eSpark-Backup/bradford-fermin-led-control/Design Files/Main-Board-v1.0/Deliverables/Rendering/3D Bottom View.png

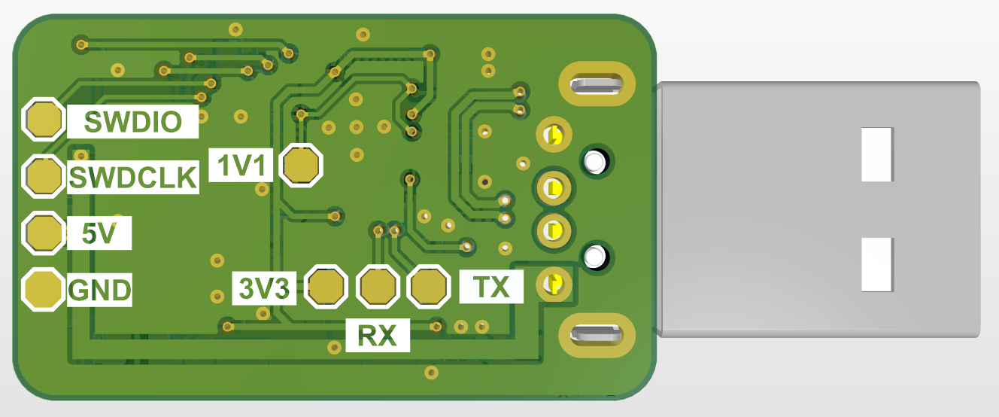
Design Files/Main-Board-v1.0/Deliverables/Rendering/3D Bottom View.png
