eSpark-Backup/bradford-fermin-led-control/Design Files/LED Board - v1.0/Deliverables/Renderings/2D View.png

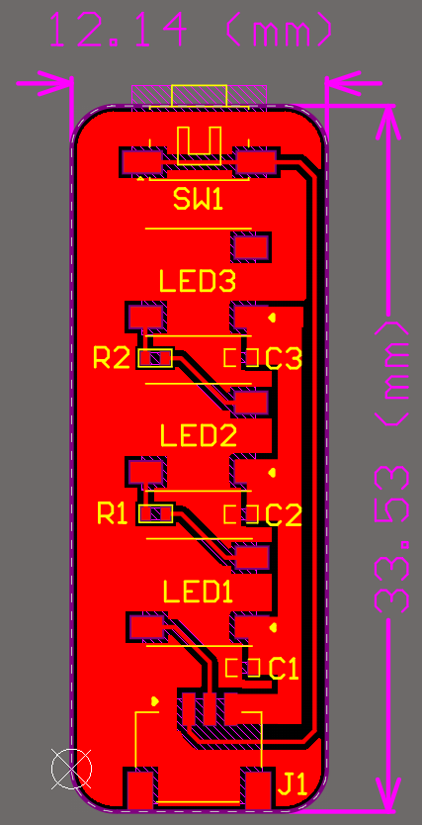
Design Files/LED Board - v1.0/Deliverables/Renderings/2D View.png
