eSpark-Backup/bradford-fermin-led-control/Design Files/LED Board - v1.0/Deliverables/Renderings/3D Bottom.png

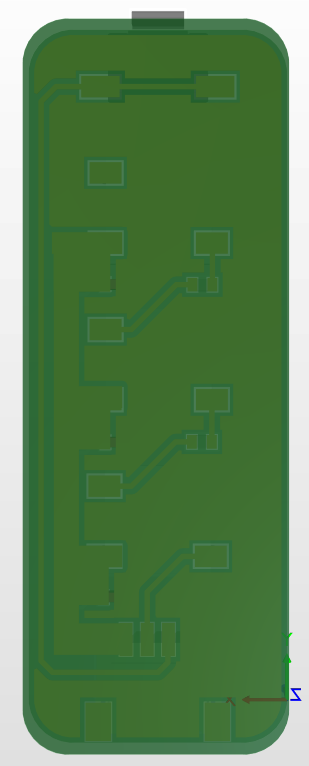
Design Files/LED Board - v1.0/Deliverables/Renderings/3D Bottom.png
