eSpark-Backup/bradford-fermin-led-control/Design Files/Main-Board-v1.0/Deliverables/Rendering/2D View.png

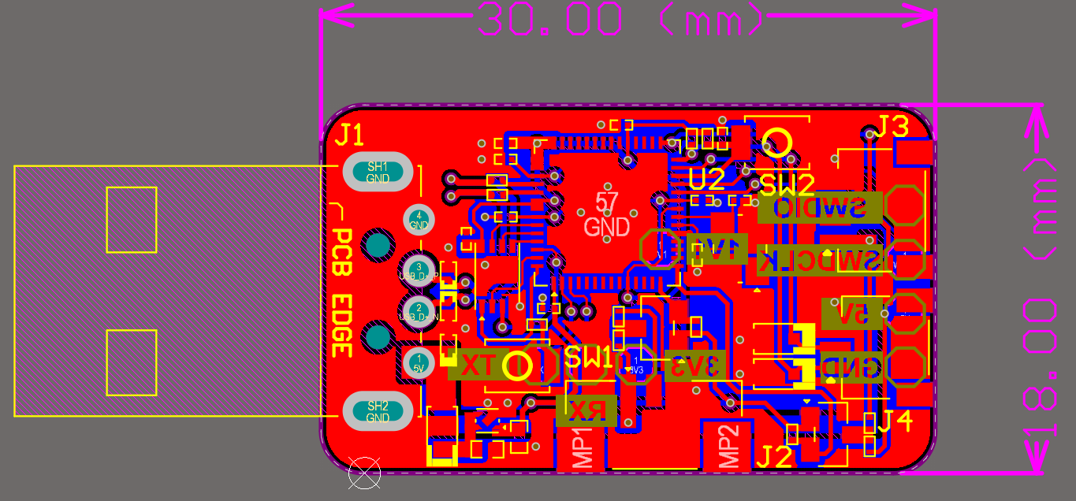
Design Files/Main-Board-v1.0/Deliverables/Rendering/2D View.png
