eSpark-Backup/bradford-fermin-led-control/Design Files/Switch Board-v1.0/Deliverables/Rendering/3D Bottom View.png

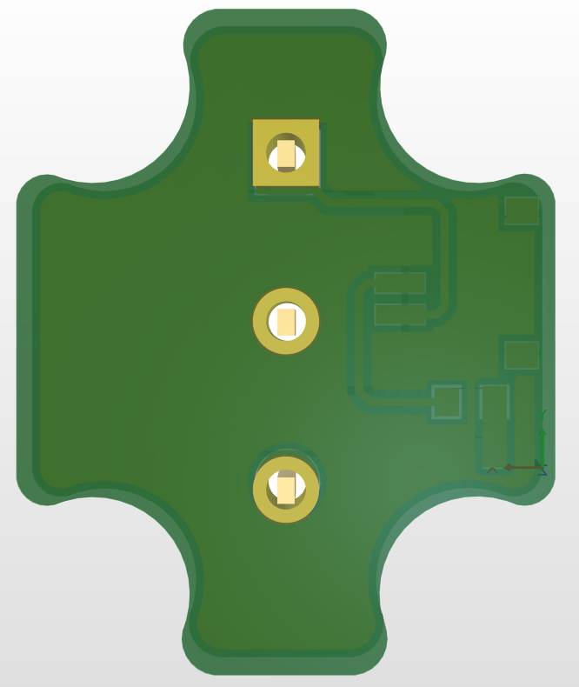
Design Files/Switch Board-v1.0/Deliverables/Rendering/3D Bottom View.png
