eSpark-Backup/bradford-fermin-led-control/Design Files/LED Board - v1.0/BOM/Client-BOM-LED Board-v1.0.xlsx

# | Item Type | Designator | Description | Footprint | Manufacturer Part Number | Manufacturer | Value | Quantity | Remarks
1 | Capacitor | C1, C2, C3 | CAP CER 0.1UF 25V X5R 0402 | Cap-0402 | CC0402KRX5R8BB104 | Yageo | 100nF | 3
2 | Headers and Wire Housings | J1 | 1x4P 4P 1 SH 1mm Tin 4 -25℃~+85℃ Brass 1A Horizontal attachment SMD,P=1mm,Surface Mount，Right Angle Wire To Board Connector ROHS | Custom | ZX-SH1.0-4PWT | JST | - | 1
3 | RGB LED | LED1, LED2, LED3 | SMD5050 Light Emitting Diodes (LED) ROHS | Custom | WS2812B-XF02/W | Worldsemi | - | 3
4 | Resistor | R1, R2 | RES 75 OHM 5% 1/16W 0402 | Res-0402 | RC0402JR-0775RL | Yageo | 75R | 2
5 | Tactile Switch | SW1 | SWITCH TACTILE SPST-NO 0.05A 12V | Custom | EVQ-PUA02K | Panasonic | - | 1
