eSpark-Backup/bradford-fermin-led-control/Design Files/LED Board - v1.0/BOM/JLCPCB-BOM-LED Board-v1.0.xlsx

Comment | Designator | Footprint | LCSC Part Number
100nF | C1, C2, C3 | Cap-0402 | C106256
ZX-SH1.0-4PWT | J1 | ZX-SH1.0-4PWT | C7430446
WS2812B-XF02/W | LED1, LED2, LED3 | WS2812B-XF02/W | C4154882
75R | R1, R2 | Res-0402 | C137841
EVQ-PUA02K | SW1 | EVQPUA02K | C128539
