eSpark-Backup/bradford-fermin-led-control/Design Files/Main-Board-v1.0/BOM/Client-BOM-Main Board - v1.0.xlsx

# | Item Type | Designator | Description | Footprint | Manufacturer Part Number | Manufacturer | Value | Quantity | Remarks
1 | Capacitor | C1, C2 | CAP CER 10UF 10V X5R 0402 | Cap-0402 | CL05A106MP5NUNC | Samsung | 10uF | 2
2 | Capacitors | C3, C4, C5, C6, C7, C11, C12 | CAP CER 0.1UF 25V X5R 0201 | CAP-0201 | GRM033R61E104ME14D | Murata | 0.1uF | 7
3 | Capacitor | C8 | CAP CER 1UF 6.3V X5R 0201 | Cap-0201 | CC0201KRX5R5BB105 | Yageo | 1uF | 1
4 | Capacitor | C9, C10 | CAP CER 15PF 50V C0G/NPO 0201 | Cap-0201 | CC0201JRNPO9BN150 | Yageo | 15pF | 2
5 | Diode | D1 | DIODE SCHOTTKY 20V 1A SOD323 | SOD-323 | NSR0320MW2T1G | ON Semiconductor | - | 1
6 | TVS Diodes | D2, D3, D4 | TVS DIODE 5VWM 9VC SOD923 | SOD-923. | DF2S6.8FS,L3M | Toshiba | - | 3
7 | Diode | D5, D6 | DIODE ZENER 3.3V 200MW SOD323F | SOD323F | MM3Z3V3B | ON Semiconductor / Fairchild | - | 2
8 | USB 2.0 1 4P Public Type-A Plugin USB Connectors ROHS | J1 | USB 2.0 1 4P Public Type-A Plugin USB Connectors ROHS | Custom | USB-05 | SOFNG | - | 1
9 | Connector | J2 | 1x3P 3P PicoBlade(MX 1.25) Tin 3 -25℃~+85℃ 2A 1 1.25mm Brass Standing paste SMD,P=1.25mm Wire To Board Connector ROHS | Custom | HC-1.25-3PLT | HCTL | - | 1
10 | Headers and Wire Housings | J3 | 1x4P 4P 1 SH 1mm Tin 4 -25℃~+85℃ Brass 1A Horizontal attachment SMD,P=1mm,Surface Mount，Right Angle Wire To Board Connector ROHS | Custom | ZX-SH1.0-4PWT | JST | - | 1
11 | Connectors | J4 | CONN HEADER SMD R/A 3POS 1MM | Custom | SM03B-SRSS-TB(LF)(SN) | JST | - | 1
12 | Mosfet | Q1, Q2 | N-CHANNEL 20-V (D-S) MOSFET | Sot-23 | SI2302CDS | TECH PUBLIC | - | 2
13 | Resistors | R1, R2 | RES 27 OHM 1% 1/20W 0201 | Res-0201 | RC0201FR-0727RL | Yageo | 27R | 2
14 | Resistor | R3 | RES 1K OHM 1% 1/20W 0201 | Res-0201 | RC0201FR-071KL | Yageo | 1K | 1
15 | Resistor | R4, R5, R6, R8, R9, R10, R12 | RES SMD 10K OHM 1% 1/20W 0201 | Res-0201 | RC0201FR-0710KL | Yageo | 10K | 7
16 | Chip SMD Resistors | R7, R11 | RES 75 OHM 1% 1/20W 0201 | Res-0201 | RC0201FR-0775RL | Yageo | 75R | 2
17 | Switch | SW1, SW2 | SWITCH TACTILE SPST-NO 0.05A 12V | Custom | B3U-1000P | Omron | - | 2
18 | IC | U1 | 500mA 70dB@(1kHz) Fixed 3.3V Positive electrode 7.5V XDFN-4-EP(1x1) Voltage Regulators - Linear, Low Drop Out (LDO) Regulators ROHS | XDFN-4-EP(1x1) | RS3236-3.3YUTDN4 | RUNIC Technology | - | 1
19 | IC | U2 | 133MHz LQFN-56(7x7) Microcontrollers (MCU/MPU/SOC) ROHS | 56-QFN (7x7) | RP2040 | Raspberry Pi | - | 1
20 | IC | U3 | IC FLASH 16MBIT SPI/QUAD 8USON | USON-8(2x3) | GD25Q16EEIGR | GigaDevice | - | 1
21 | Crytal | X1 | CRYSTAL 12.0000MHZ 10PF SMD | SMD3225-4P | ABM8-272-T3 | Abracon | 12Mhz | 1
