eSpark-Backup/bradford-fermin-led-control/Design Files/Switch Board-v1.0/BOM/Client-BOM-Switch_Board-v1.0.xlsx

# | Item Type | Designator | Description | Footprint | Manufacturer Part Number | Manufacturer | Value | Quantity | Remarks
1 | Connectors | J1 | CONN HEADER SMD R/A 3POS 1MM | Custom | SM03B-SRSS-TB(LF)(SN) | JST | - | 1
2 | LED | LED1 | RED LED 0603 Light Emitting Diodes | LED-0603 | NCD0603R3 | Foshan NationStar Optoelectronics | - | 1
3 | Resistor | R1 | RES SMD 220 OHM 1% 1/10W 0603 | Res-0603 | RC0603FR-07220RL | Yageo | 220R | 1
4 | Switch | SW1 | 1A 30V Single Pole Double Throw (SPDT) 1,000,000 Times Plugin Limit Switches ROHS | Custom | DM1-135P | XKB Connectivity | - | 1
