eSpark-Backup/bradford-fermin-led-control/Design Files/Switch Board-v1.0/BOM/JLCPCB-BOM-Switch_Board-v1.0.xlsx

Comment | Designator | Footprint | LCSC Part Number
SM03B-SRSS-TB(LF)(SN) | J1 | SM03B-SRSS-TB(LF)(SN) | C160403
RED | LED1 | LED-0603 | C3151730
220R | R1 | Res-0603 | C107696
DM1-135P | SW1 | DM1-135P | C480264
