eSpark-Backup/bradford-fermin-led-control/Design Files/Main-Board-v1.0/Deliverables/Supporting Files/Main Board-v1.0.step

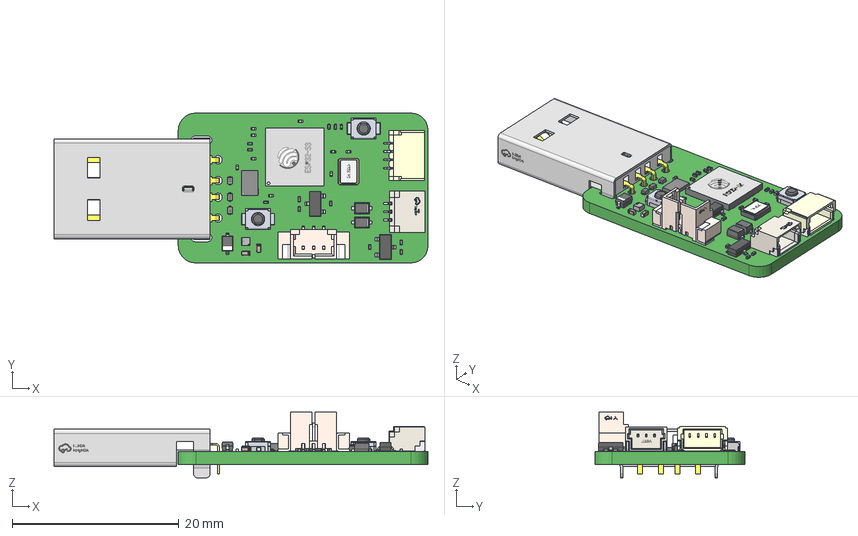
[picture p10: CAD file, 2025-01-02]
Design Files/Main-Board-v1.0/Deliverables/Supporting Files/Main Board-v1.0.step
44.9 x 18.0 x 7.91 mm
User Library-0201(0603M) Res x 11
CircuitWorks-SOT-23 x 2
SM04B-SRSS-TB
User Library-SOD323F-1 x 2
User Library-SMD Ceramic Capacitors_0201 (0603)_AB x 10
User Library-User Library-Siward_SX3225
ESP32-S3-QFN56-77-44.dwg
User Library-OMRON B3U1000P x 2
User Library-DIODE_SOD-923 x 3
User Library-SOD323-1
User Library-Capacitor 0402 x 2
