eSpark-Backup/bradford-fermin-led-control/Design Files/LED Board - v1.0/Deliverables/Supporting Files/LED_Brd-v1.0.step

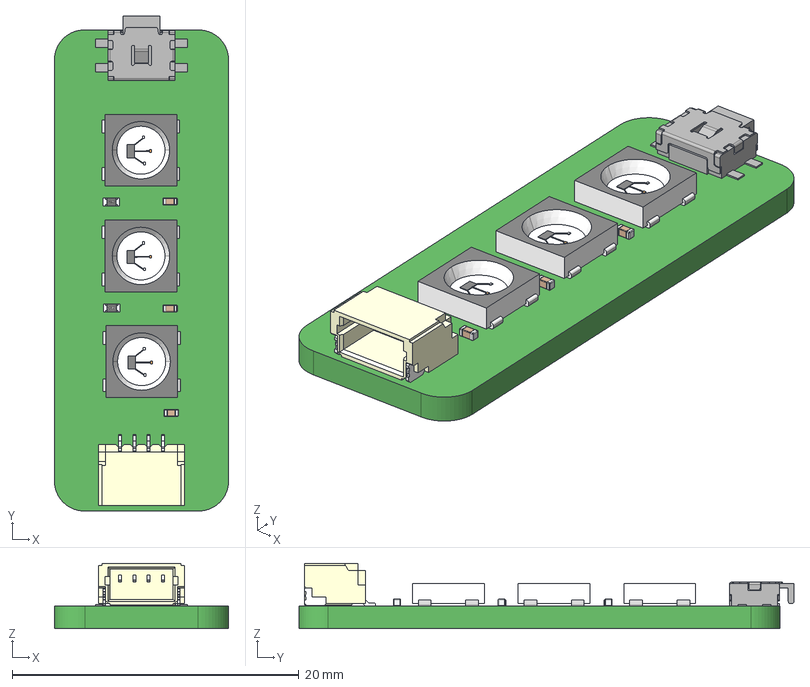
[picture p11: CAD file, 2025-01-02]
Design Files/LED Board - v1.0/Deliverables/Supporting Files/LED_Brd-v1.0.step
12.1 x 34.5 x 4.55 mm
User Library-Capacitor 0402 x 3
COMPOUND001.step
COMPOUND002.step
User Library-RES_1005-0402 x 2
WS2812B-BW x 3
SM04B-SRSS-TB
