eSpark-Backup/bradford-fermin-led-control/Design Files/Switch Board-v1.0/Deliverables/Supporting Files/Sw-Board-v1.0.step

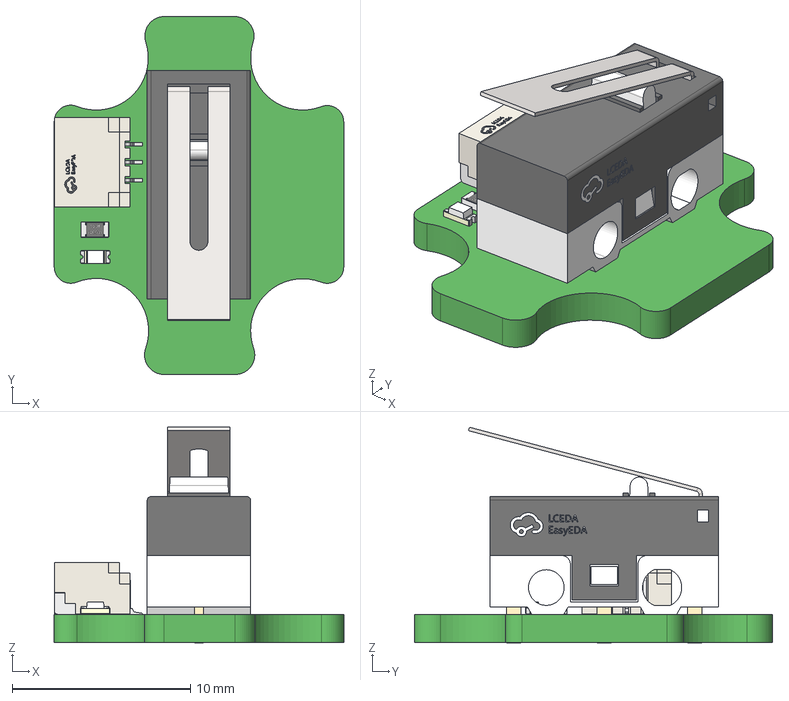
[picture p12: CAD file, 2025-01-02]
Design Files/Switch Board-v1.0/Deliverables/Supporting Files/Sw-Board-v1.0.step
16.2 x 20.1 x 12.1 mm
User Library-RESC1608X05N
User Library-LED SMD0603
