eSpark-Backup/bradford-fermin-led-control/docs/Client-Files/Step-Files/mockPCB.stp

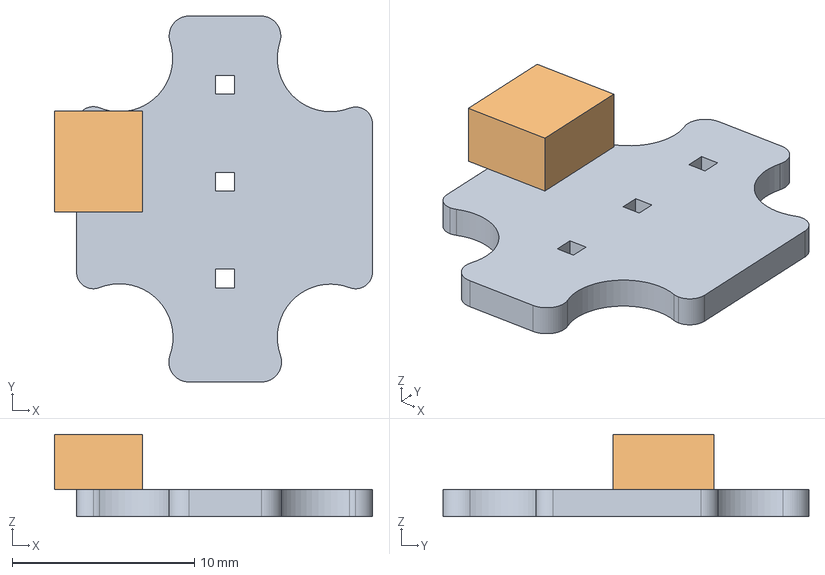
[picture p13: CAD file, 2024-12-30]
docs/Client-Files/Step-Files/mockPCB.stp
17.5 x 20.1 x 4.53 mm
