eSpark-Backup/bradford-fermin-led-control/docs/Client-Files/Step-Files/mockPCB_Switch.stp

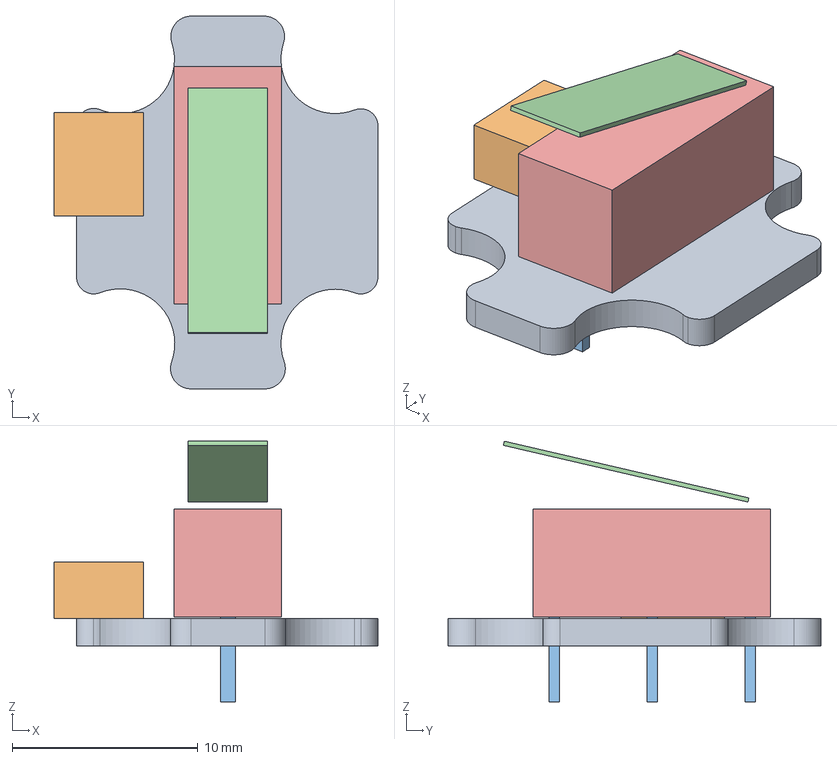
[picture p14: CAD file, 2024-12-30]
docs/Client-Files/Step-Files/mockPCB_Switch.stp
17.5 x 20.1 x 14.0 mm
