eSpark-Backup/bradford-fermin-led-control/(list of files, cad)

Other CAD files:
Design Files/LED Board - v1.0/Deliverables/Supporting Files/LED_Brd-v1.0.DXF
Design Files/Main-Board-v1.0/Deliverables/Supporting Files/Main Board-v1.0.DXF
Design Files/Switch Board-v1.0/Deliverables/Supporting Files/Sw-Board-v1.0.DXF
