eSpark-Backup/bradford-fermin-led-control/Design Files/Switch Board-v1.0/Deliverables/Schematic/Switch_Board-v1.0.pdf

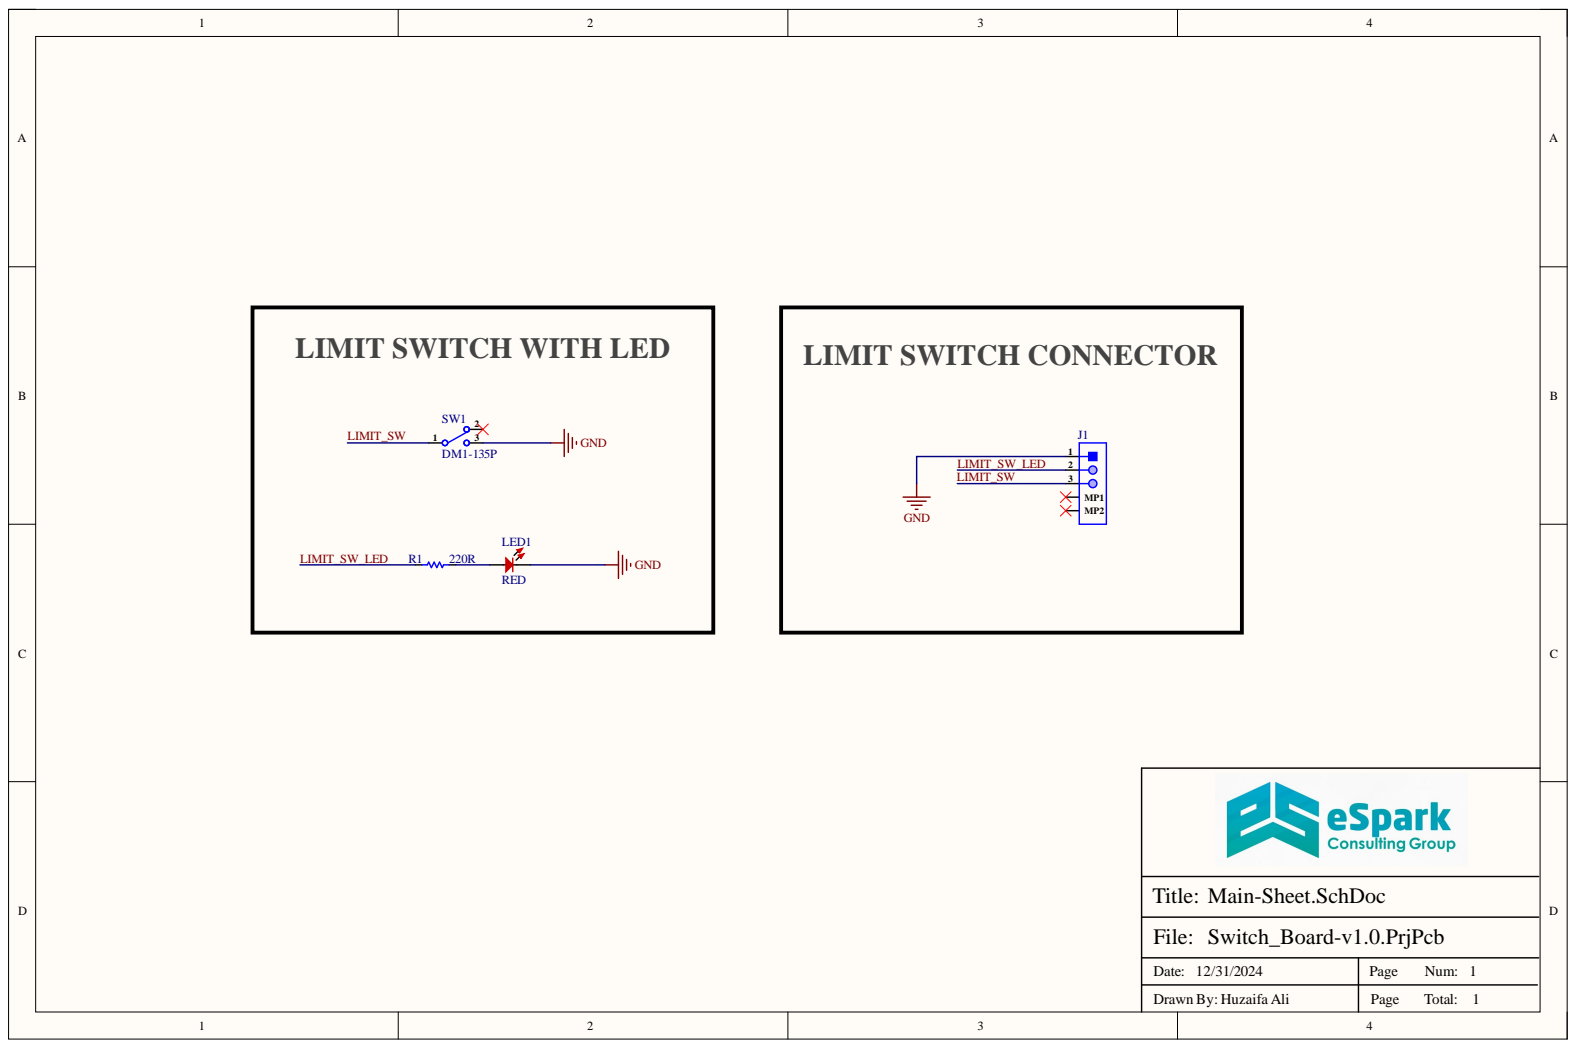
[picture p15: page 1]

Dat e : 1 2 / 3 1 / 2 0 2 4 | Pag e N u m : 11

D raw n B y : H uzai fa A l i | Pag e To t al :

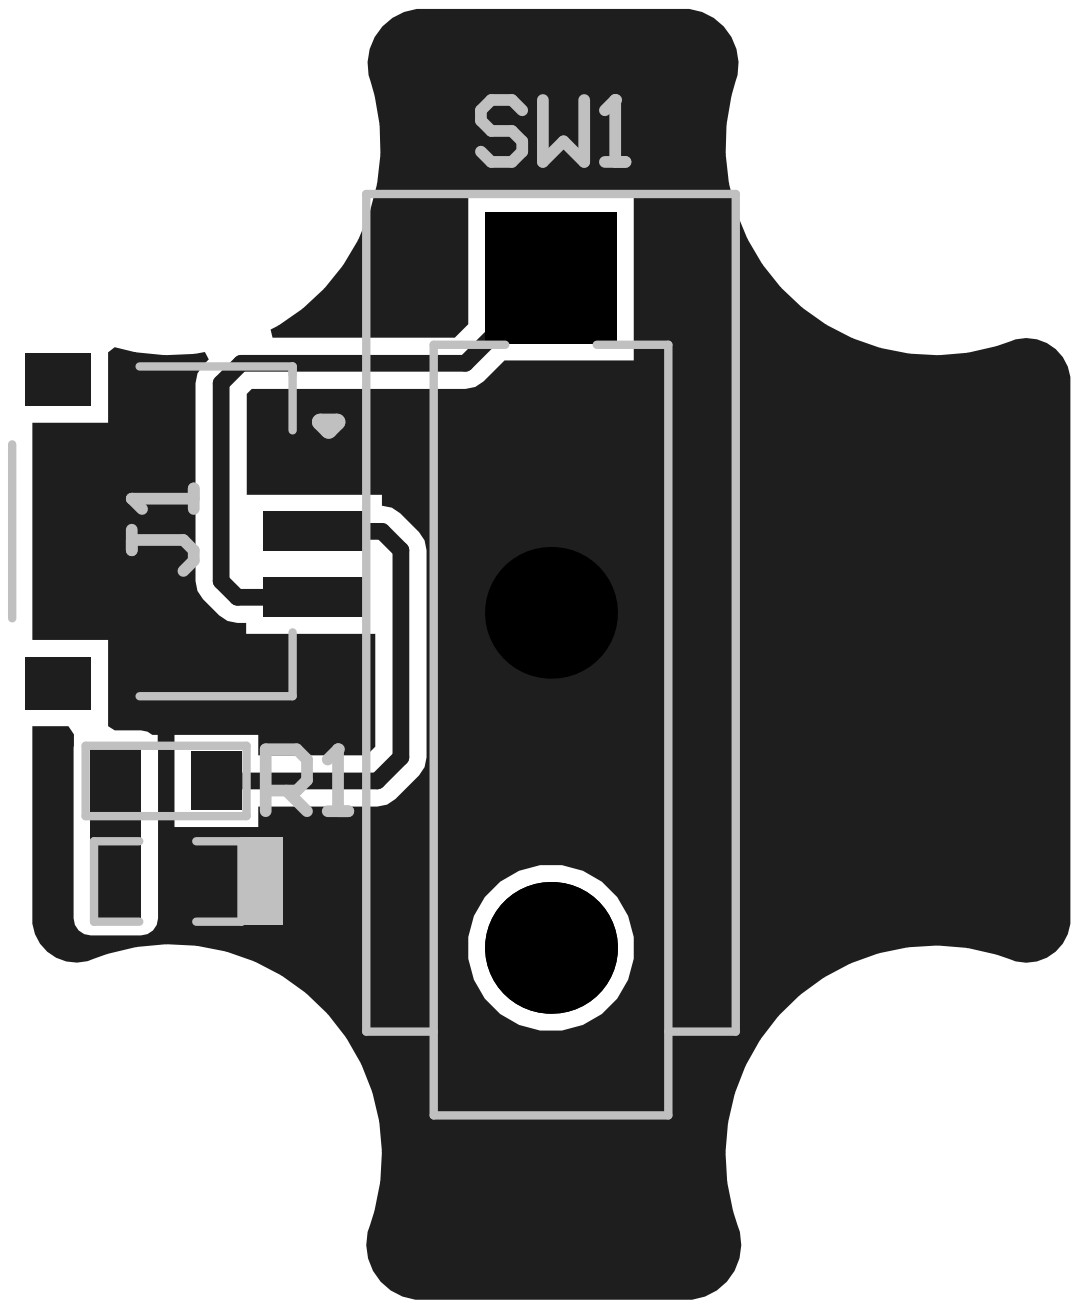
[picture p16: page 2]

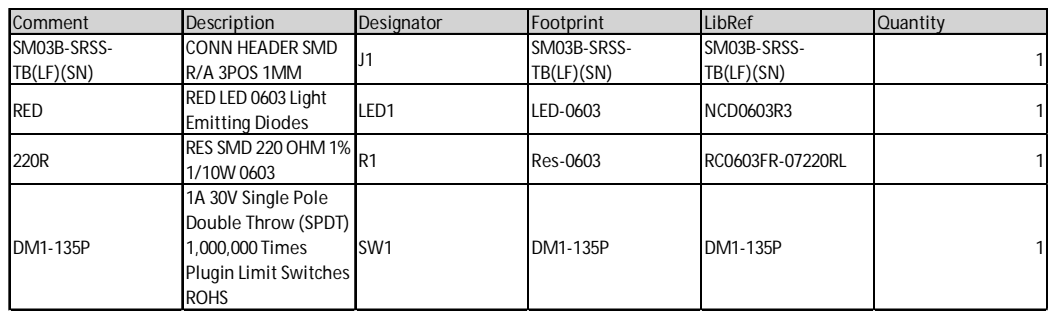
[picture p17: page 3]

Comment | Description | Designator | Footprint | LibRef | Quantity
SM03B-SRSS-TB(LF)(SN) | CONN HEADER SMD R/A 3POS 1MM | J1 | SM03B-SRSS-TB(LF)(SN) | SM03B-SRSS-TB(LF)(SN) | 1

RED | RED LED 0603 Light Emitting Diodes | LED1 | LED-0603 | NCD0603R3 | 1

220R | RES SMD 220OHM 1% 1/10W 0603 | R1 | Res-0603 | RC0603FR-07220RL | 1

DM1-135P | 1A 30V Single Pole Double Throw (SPDT) 1,000,000 Times Plugin Limit Switches ROHS | SW1 | DM1-135P | DM1-135P | 1
