eSpark-Backup/bradford-fermin-led-control/Design Files/Main-Board-v1.0/Deliverables/Schematic/Main Board - v1.0.pdf

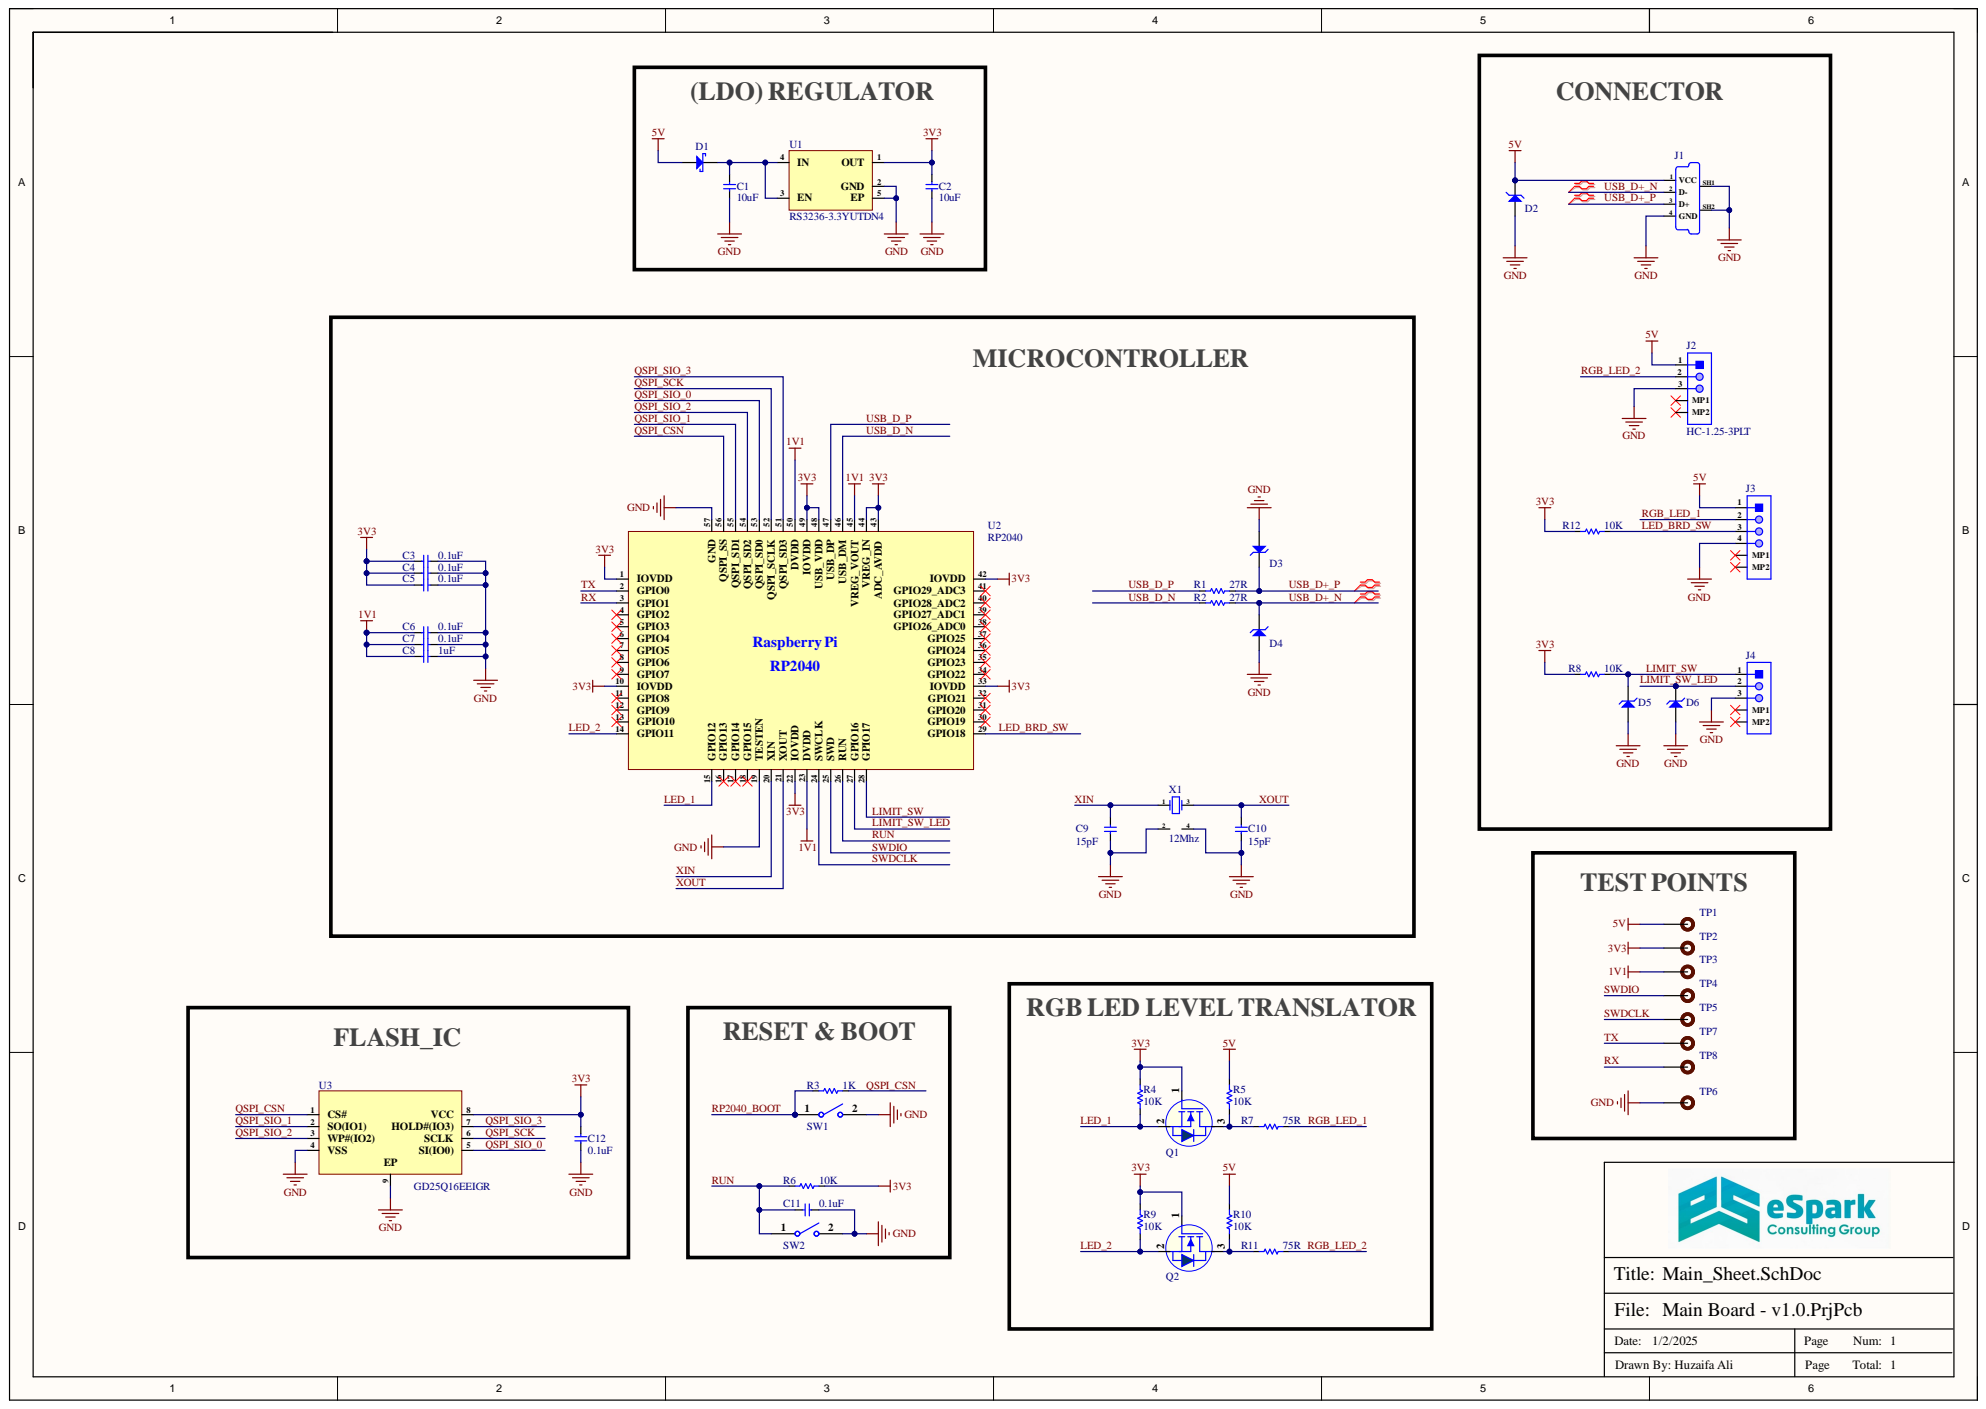
[picture p18: page 1]

C4 | 0.1uF
C5 | 0.1uF

DVDD 23 IOVDD 22 XOUT 21 XIN 20 TESTEN 19

Date: 1/2/2025 | Page Num: 1

Drawn By: Huzaifa Ali | Page Total: 1

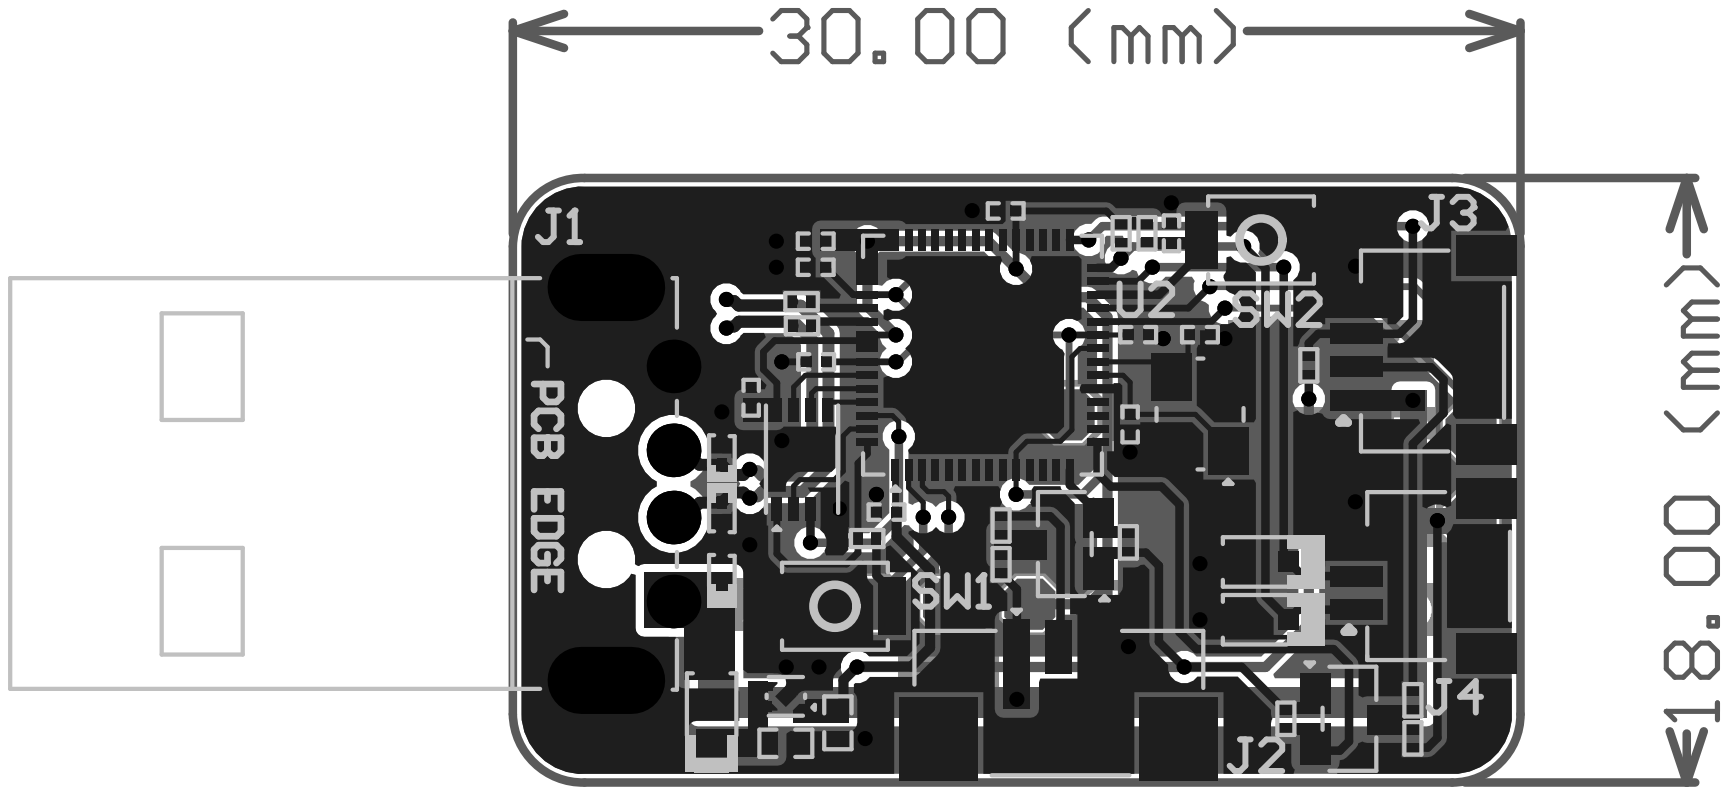
[picture p19: page 2]
