eSpark-Backup/bradford-fermin-led-control/Design Files/LED Board - v1.0/Deliverables/Schematic/LED Board-v1.0.pdf

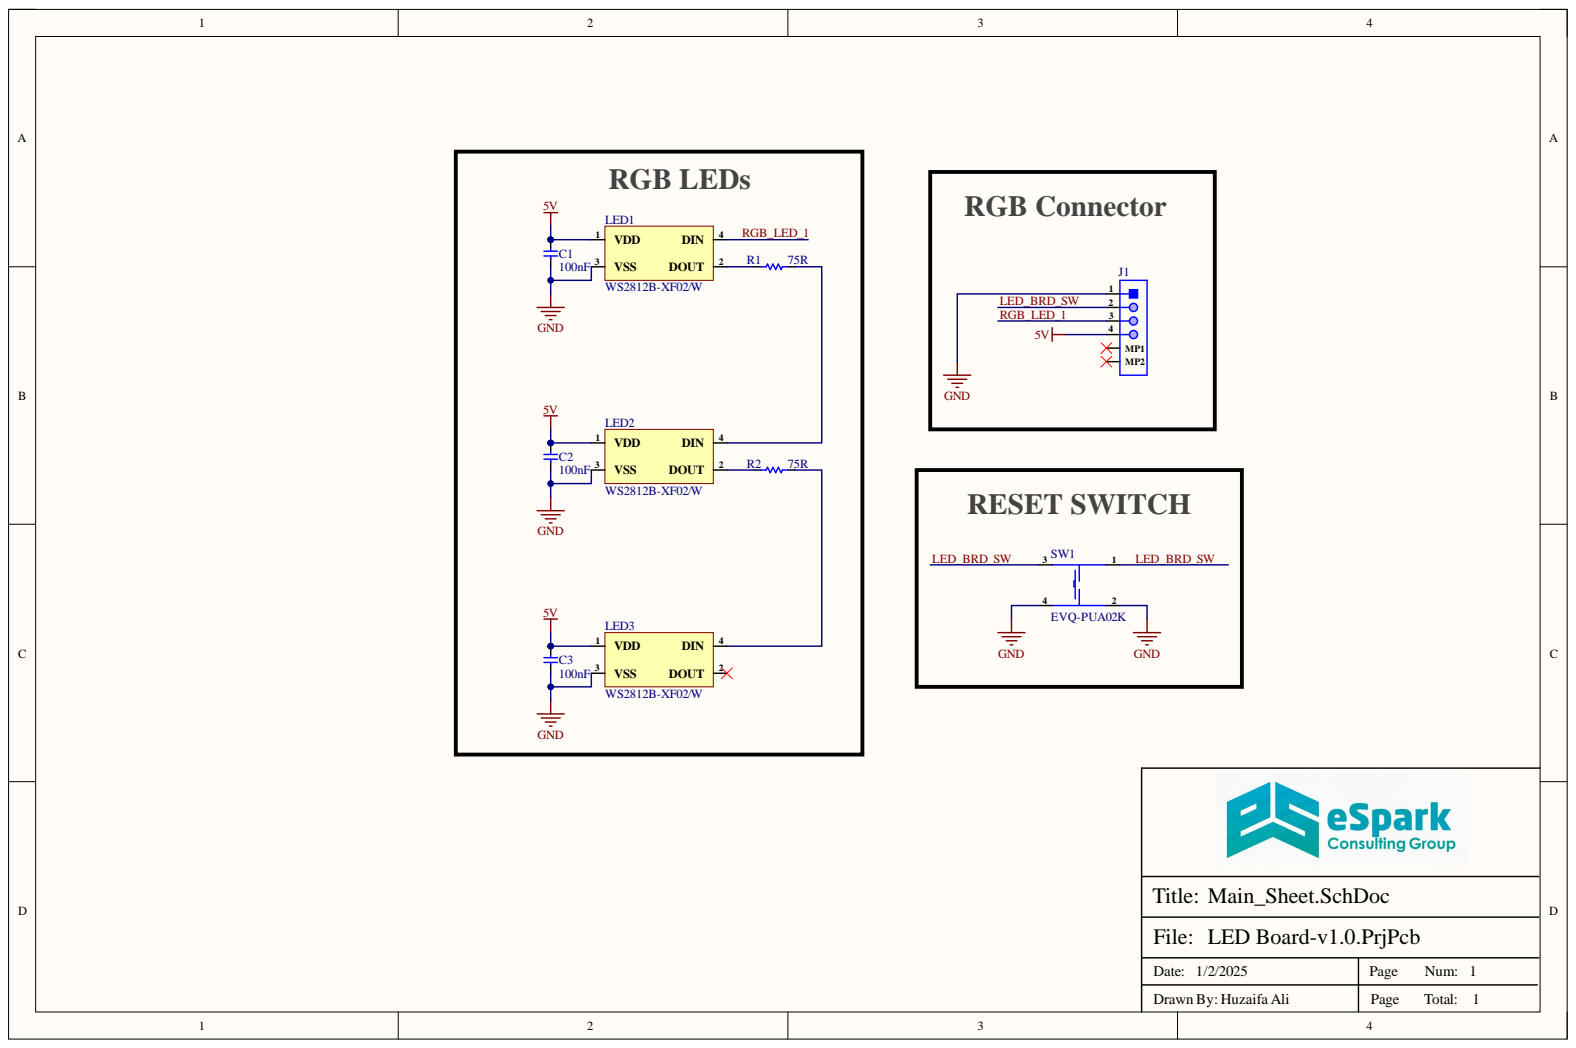
[picture p20: page 1]

Date: 1/2/2025 | Page Num: 1

Drawn By: Huzaifa Ali | Page Total: 1

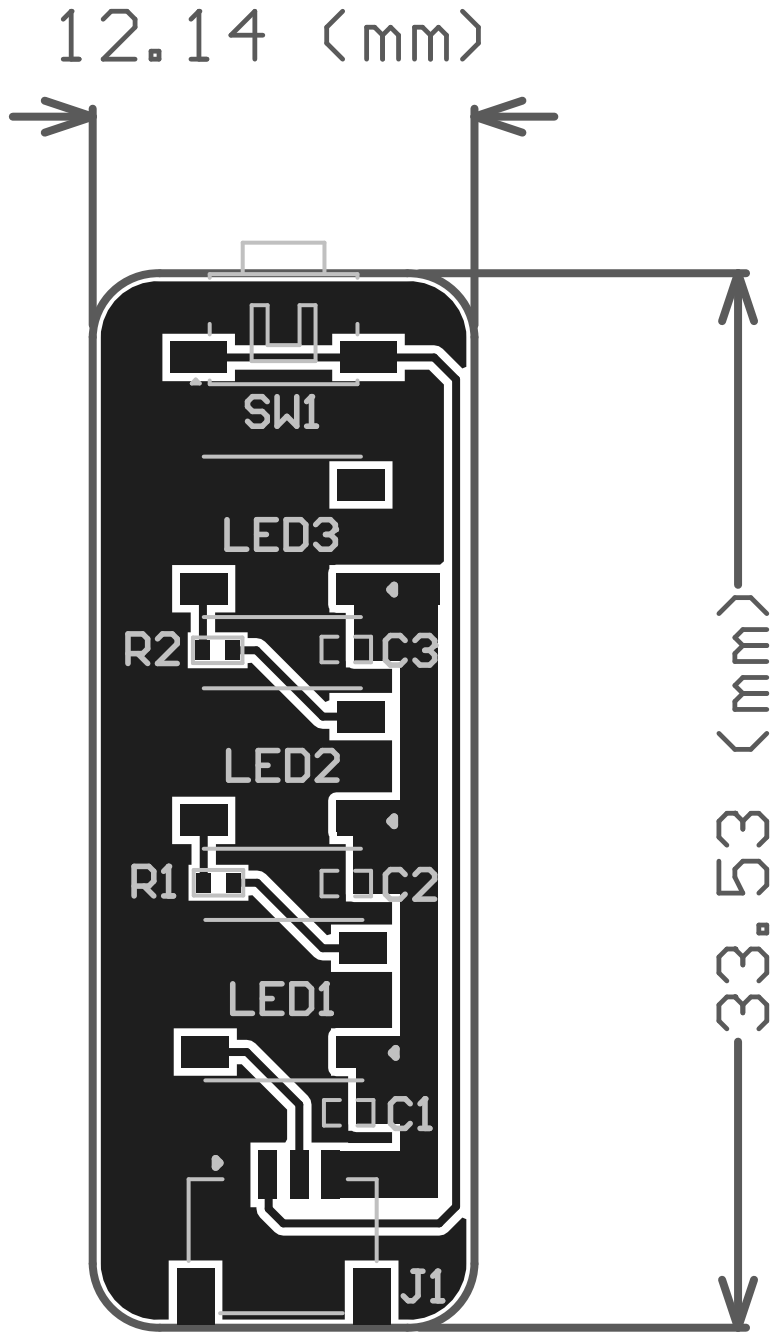
[picture p21: page 2]
