eSpark-Backup/bradford-fermin-led-control/(list of files, drawings)

Other design files:
Design Files/LED Board - v1.0/LED Board-v1.0.PrjPcb
Design Files/LED Board - v1.0/LED_Brd-v1.0.PcbDoc
Design Files/LED Board - v1.0/Main_Sheet.SchDoc
Design Files/LED-Control-Board-v1.0/LED-Control-Board-v1.0.PrjPcb
Design Files/Main-Board-v1.0/Main Board - v1.0.PrjPcb
Design Files/Main-Board-v1.0/Main Board-v1.0.PcbDoc
Design Files/Main-Board-v1.0/Main_Sheet.SchDoc
Design Files/Switch Board-v1.0/Main-Sheet.SchDoc
Design Files/Switch Board-v1.0/Sw-Board-v1.0.PcbDoc
Design Files/Switch Board-v1.0/Switch_Board-v1.0.PrjPcb
