eSpark-Backup/bradford-fermin-led-control/(commit log)

2024-12-26 #1 Schematic Complete.
    [LED-Control-Board-v1.0.PrjPcb, LED_Control_PCB.PcbDoc, Main_Sheet.SchDoc]
2024-12-26 #1 Test Point added.
    [Main_Sheet.SchDoc]
2024-12-27 #1 Limit Switch Pull up resistor and Zener Diode added.
    [Main_Sheet.SchDoc]
2024-12-27 #3 Updated Files.
    [LED_Control_PCB.PcbDoc, Main_Sheet.SchDoc]
2024-12-30 Step files added
    [mockPCB.stp, mockPCB_Switch.stp]
2024-12-30 #5 #4 #3 Schematic Complete and LED Board PCB Also.
    [LED Board-v1.0.PrjPcb, LED_Brd-v1.0.PcbDoc, LED_Control_PCB.PcbDoc, Main Board - v1.0.PrjPcb, Main Board-v1.0.PcbDoc, Main-Sheet.SchDoc, Main_Sheet.SchDoc, Sw-Board-v1.0.PcbDoc]
2024-12-31 #5 #4 PCB Completed.
    [LED Board-v1.0.PrjPcb, LED_Brd-v1.0.PcbDoc, Main Board - v1.0.PrjPcb, Main Board-v1.0.PcbDoc, Main-Sheet.SchDoc, Main_Sheet.SchDoc, Sw-Board-v1.0.PcbDoc, Switch_Board-v1.0.PrjPcb]
2025-01-01 #3 PCB Completed.
    [Main Board - v1.0.PrjPcb, Main Board-v1.0.PcbDoc, Main_Sheet.SchDoc]
2025-01-02 #6 #4 LED BOARD REVIEW COMPLETED
    [LED Board-v1.0.PrjPcb, LED_Brd-v1.0.PcbDoc]
2025-01-02 #1 J2 changed to Straight
    [Main_Sheet.SchDoc]
2025-01-02 #6 #3 Main Board Review completed
    [Main Board - v1.0.PrjPcb, Main Board-v1.0.PcbDoc]
2025-01-02 #6 #5 Switch Board review completed
    [Sw-Board-v1.0.PcbDoc, Switch_Board-v1.0.PrjPcb]
2025-01-02 #5 #4 #3 Deliverables Completed.
    [Centroid.csv, Client-BOM-LED Board-v1.0.xlsx, Client-BOM-Main Board - v1.0.xlsx, Client-BOM-Switch_Board-v1.0.xlsx, JLCPCB-BOM-LED Board-v1.0.xlsx, JLCPCB-BOM-Main Board - v1.0.xlsx, JLCPCB-BOM-Switch_Board-v1.0.xlsx, LED Board-v1.0.PrjPcb]
2025-01-02 #5 Dimension Added.
    [Main Board - v1.0.PrjPcb, Sw-Board-v1.0.PcbDoc]
2025-01-02 #3 Pull Up Resistor added in led Switch and Fresh Deliverables Generated Also.e Ge
    [Centroid.csv, Client-BOM-Main Board - v1.0.xlsx, JLCPCB-BOM-Main Board - v1.0.xlsx, Main Board - v1.0.PrjPcb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]
2025-01-02 #4 #3 ZX-SH1.0-4PWT Updated in BOM.
    [Client-BOM-LED Board-v1.0.xlsx, Client-BOM-Main Board - v1.0.xlsx, JLCPCB-BOM-LED Board-v1.0.xlsx, JLCPCB-BOM-Main Board - v1.0.xlsx]
2025-01-14 Task 1 completed , Task 2 Ongoing
    1. Environment setup completed
    2. building code for LED PCB sequence
2025-01-14 #8 Task 1 completed , Task 2 ongoing
    * environment setup done
    * working on LED PCB sequence
2025-01-14 #8 Task 2 comepleted , Task3 in progress
    1. led pcb sequence is done
    2. implemented the timer and interrupt logic for the switch pcb , functions are letf
    [LED Board-v1.0.PrjPcb, Main Board - v1.0.PrjPcb, Main_Sheet.SchDoc, Switch_Board-v1.0.PrjPcb]
2025-01-15 #8 Progress on switch pcb sequence
    - addressable LED integeration left
    - logic is done
2025-01-20 #8 progress on main pcb sequence
    [Sw-Board-v1.0.PcbDoc]
2025-01-21 #8 Add: timer, timing config changes
2025-01-22 #8 Bug Fix : switch led was not working on hold
    [main.c]
2025-01-24 #8 Bug Fixes and Additions: LEDs not working fix , multiple clicks register fix , LED board switch function addition
    [timing_config.txt]
